SR-Madsen/KiCadLibrary/README.md

# KiCadLibrary
Library containing KiCad symbols, footprints, and 3D models for personal projects.
