SR-Madsen/KiCadLibrary/3DModels/KSZ8081RNBCA_TR.stp

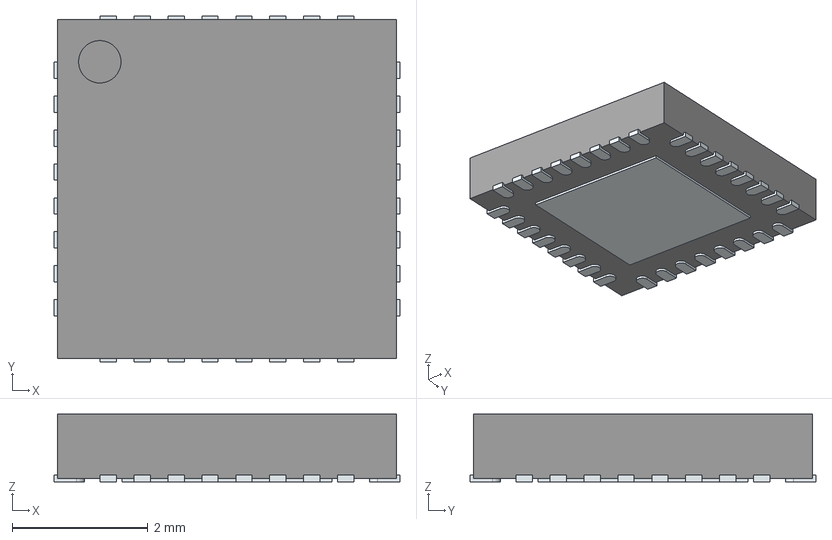
[picture p1: CAD file, 2022-05-12]
3DModels/KSZ8081RNBCA_TR.stp
5.10 x 5.10 x 1.00 mm
ThermalPin
PinsArrayLR
PinsArrayTB
