SR-Madsen/KiCadLibrary/3DModels/ECS-384-10-33B-CKY-TR.stp

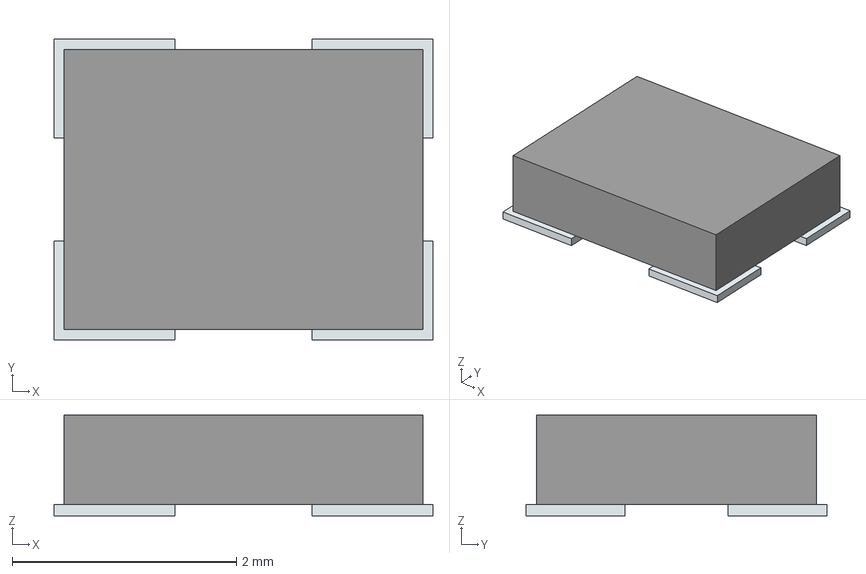
[picture p2: CAD file, 2022-05-11]
3DModels/ECS-384-10-33B-CKY-TR.stp
3.38 x 2.68 x 0.9 mm
Pins
