SR-Madsen/KiCadLibrary/3DModels/ECS-.327-12.5-12-TR.stp

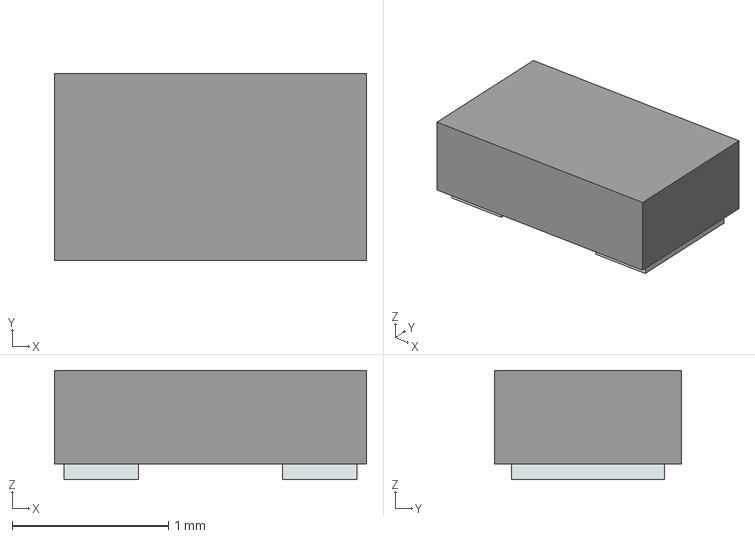
[picture p3: CAD file, 2022-05-11]
3DModels/ECS-.327-12.5-12-TR.stp
2.00 x 1.20 x 0.7 mm
Pins
