SR-Madsen/KiCadLibrary/3DModels/WF200D.stp

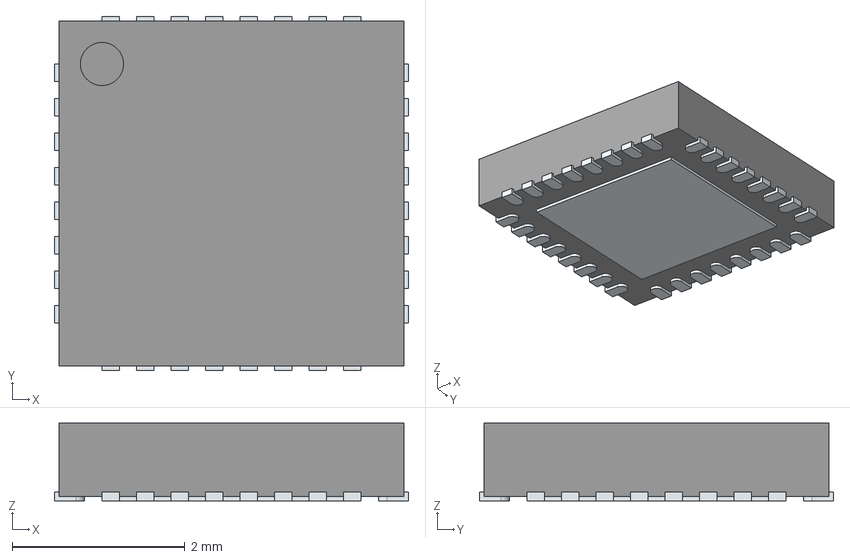
[picture p4: CAD file, 2022-05-11]
3DModels/WF200D.stp
4.10 x 4.10 x 0.9 mm
ThermalPin
PinsArrayLR
PinsArrayTB
