SR-Madsen/KiCadLibrary/3DModels/S34ML01G200BHI000.stp

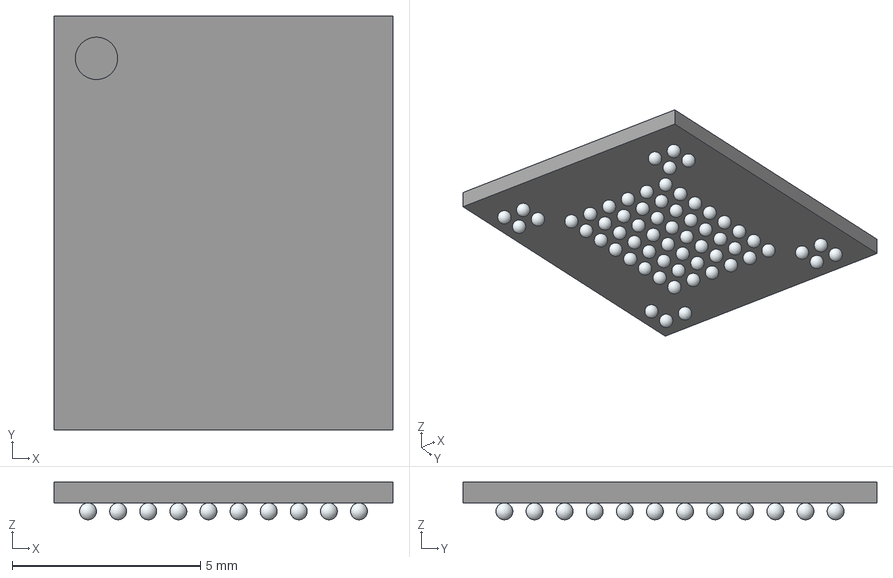
[picture p5: CAD file, 2022-05-06]
3DModels/S34ML01G200BHI000.stp
9.00 x 11.0 x 1.00 mm
A1
A2
A9
A10
B1
B9
B10
C3
C4
C5
C6
C7
C8
D3
D4
D5
D6
D7
D8
E3
E4
E5
E6
E7
E8
F3
F4
F5
F6
F7
F8
G3
G4
G5
G6
G7
G8
H3
H4
H5
H6
H7
H8
J3
J4
J5
J6
J7
J8
K3
K4
K5
K6
K7
K8
L1
L2
L9
L10
M1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
