SR-Madsen/KiCadLibrary/3DModels/PJ-102AH.step

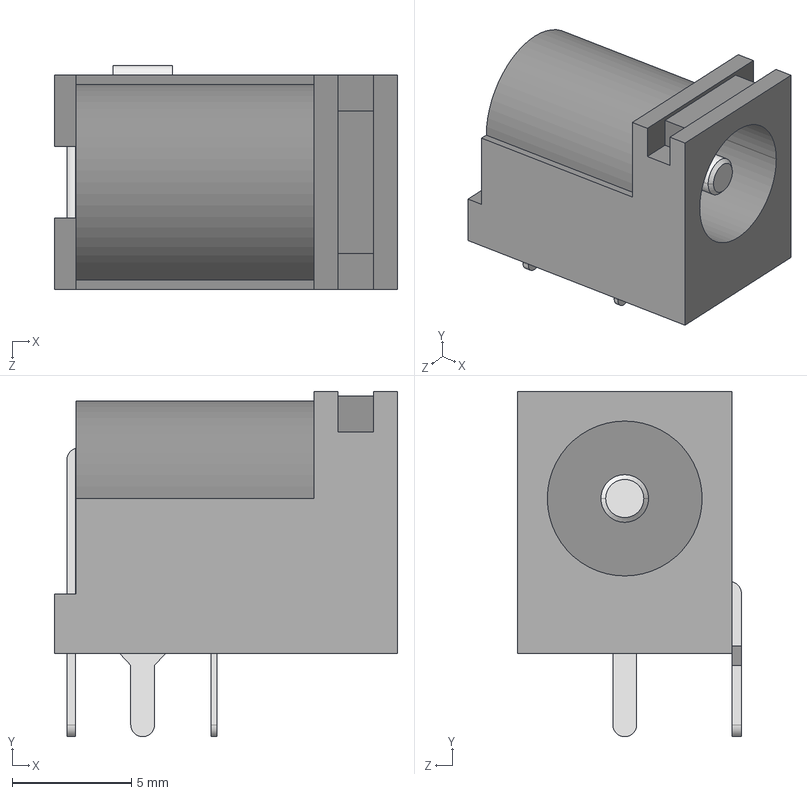
[picture p6: CAD file, 2022-05-05]
3DModels/PJ-102AH.step
14.4 x 14.5 x 9.40 mm
