SR-Madsen/KiCadLibrary/3DModels/CM1624-08DE.stp

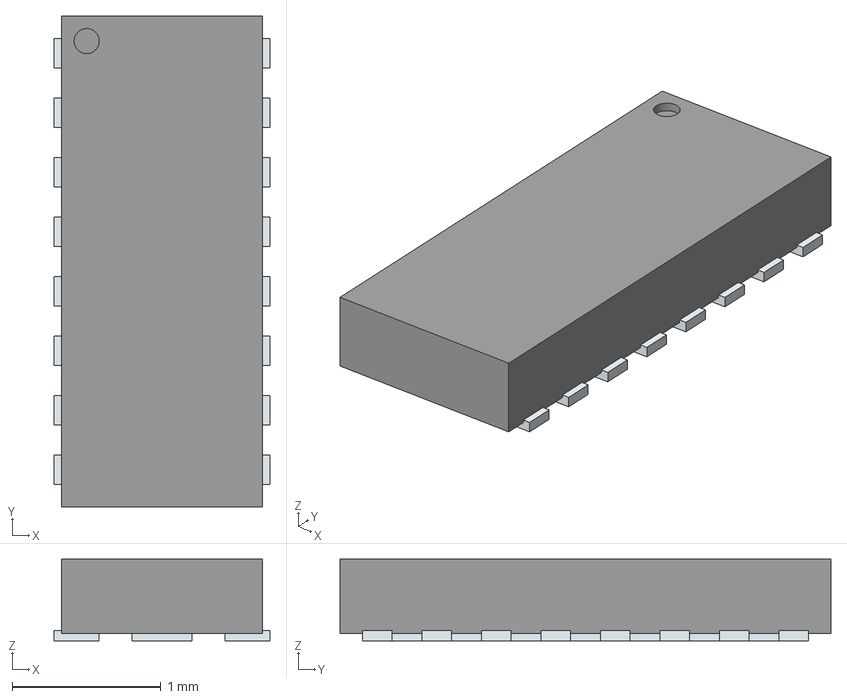
[picture p7: CAD file, 2022-04-25]
3DModels/CM1624-08DE.stp
1.45 x 3.30 x 0.55 mm
ThermalPin
PinsArrayLR
