SR-Madsen/KiCadLibrary/3DModels/TFP410PAP.stp

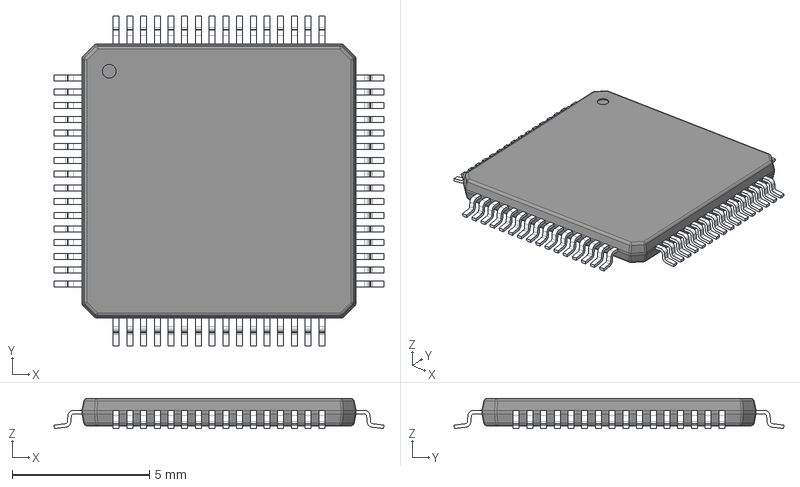
[picture p8: CAD file, 2021-12-30]
3DModels/TFP410PAP.stp
12.0 x 12.0 x 1.10 mm
BODY-QFP
LEAD-QFP x 64
THERMALPAD-PAP0064A
