SR-Madsen/KiCadLibrary/3DModels/MCP112T-315E_LB.stp

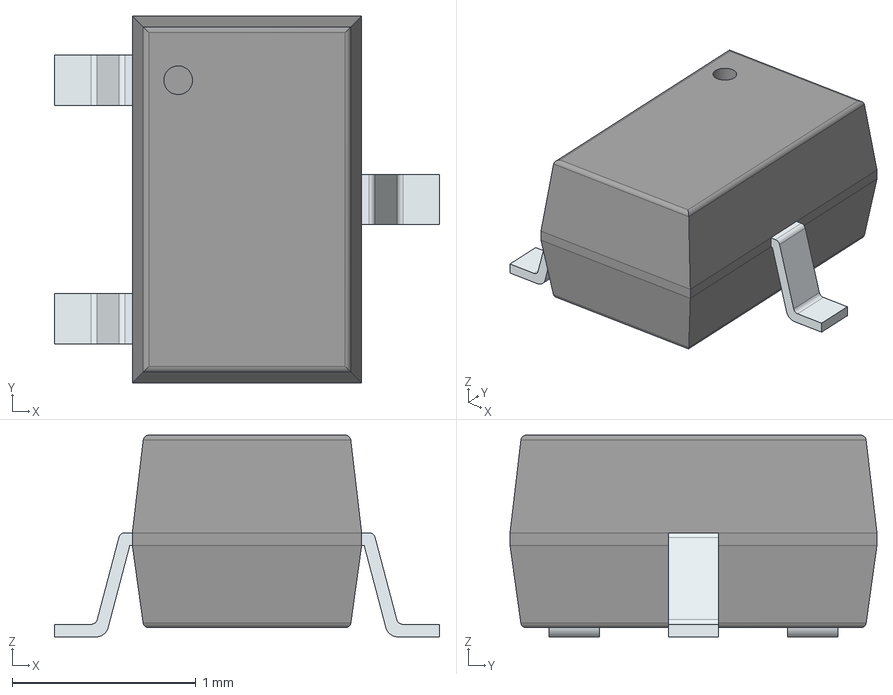
[picture p9: CAD file, 2021-02-15]
3DModels/MCP112T-315E_LB.stp
2.10 x 2.00 x 1.10 mm
PinsArrayL
FilletPinR
