SR-Madsen/KiCadLibrary/3DModels/PESD12VA-SFYL.stp

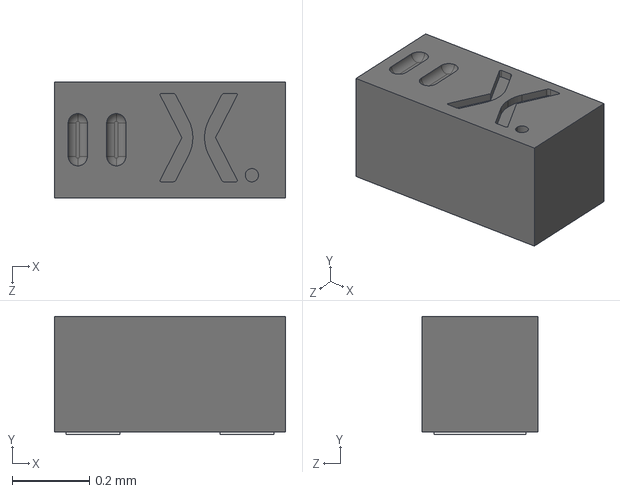
[picture p11: CAD file, 2021-02-15]
3DModels/PESD12VA-SFYL.stp
0.6 x 0.308 x 0.3 mm
