SR-Madsen/KiCadLibrary/3DModels/RJMG1BD3B8K1ANR.STEP

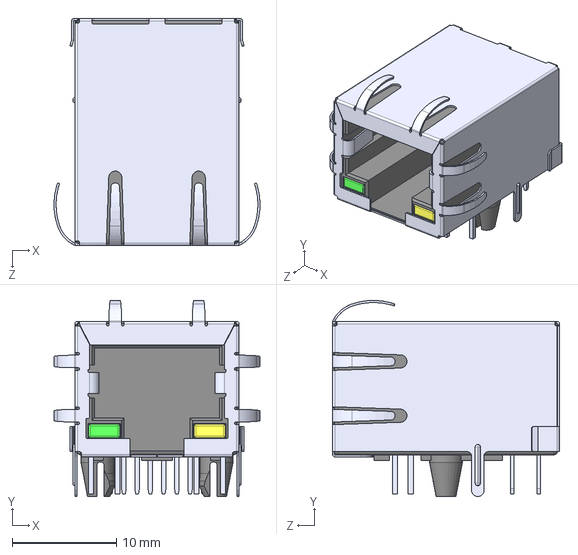
[picture p12: CAD file, 2021-01-28]
3DModels/RJMG1BD3B8K1ANR.STEP
19.7 x 18.8 x 21.8 mm
