SR-Madsen/KiCadLibrary/3DModels/MCIMX6Y2CVM08AB.stp

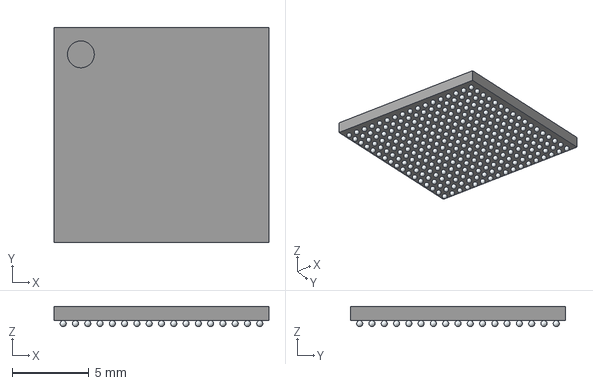
[picture p13: CAD file, 2021-01-21]
3DModels/MCIMX6Y2CVM08AB.stp
14.0 x 14.0 x 1.32 mm
