SR-Madsen/KiCadLibrary/3DModels/ECS-271.2-10-37.stp

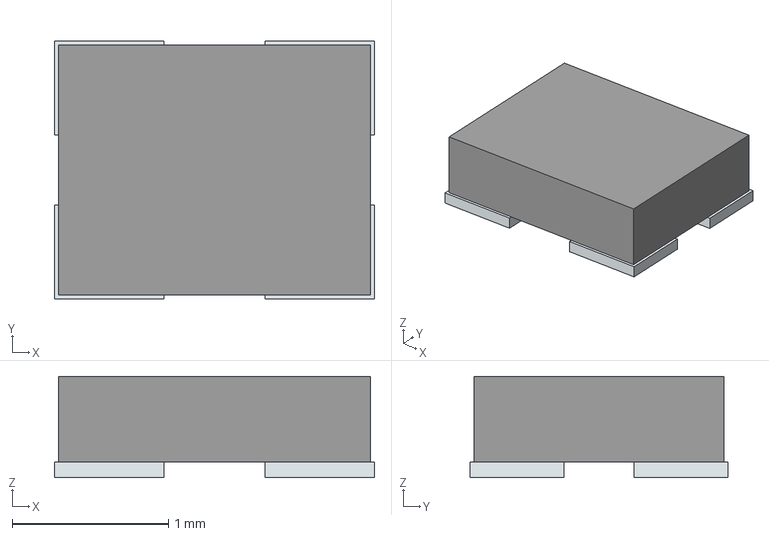
[picture p14: CAD file, 2020-12-07]
3DModels/ECS-271.2-10-37.stp
2.05 x 1.65 x 0.65 mm
Pins
