SR-Madsen/KiCadLibrary/3DModels/SHT40-AD1B-R2.stp

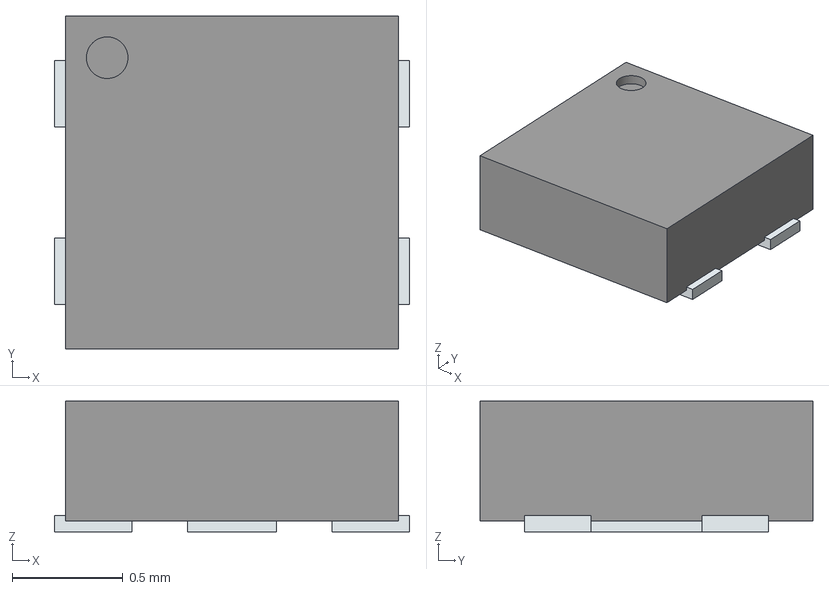
[picture p15: CAD file, 2020-12-05]
3DModels/SHT40-AD1B-R2.stp
1.60 x 1.50 x 0.59 mm
ThermalPin
PinsArrayLR
