SR-Madsen/KiCadLibrary/3DModels/IS25WQ040-JNLE.stp

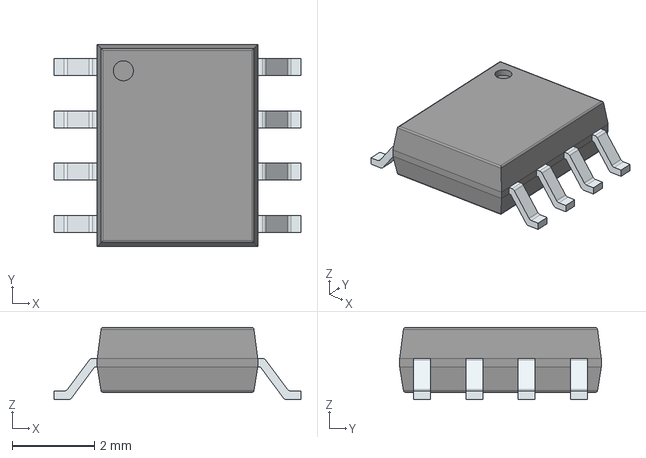
[picture p16: CAD file, 2020-11-23]
3DModels/IS25WQ040-JNLE.stp
6.00 x 4.90 x 1.75 mm
PinsArrayLR
