SR-Madsen/KiCadLibrary/3DModels/CR2450.stp

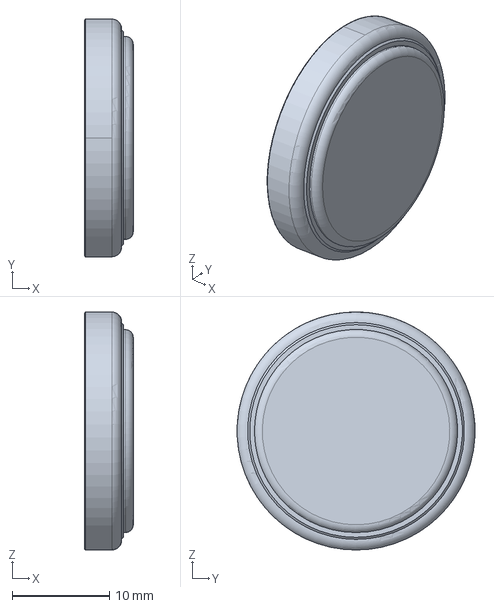
[picture p17: CAD file, 2020-11-23]
3DModels/CR2450.stp
5.00 x 24.5 x 24.5 mm
