SR-Madsen/KiCadLibrary/3DModels/2450FB15L0001.step

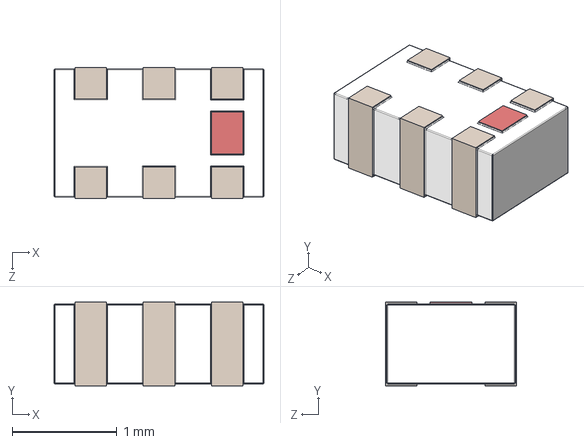
[picture p18: CAD file, 2020-11-23]
3DModels/2450FB15L0001.step
2.00 x 0.8 x 1.25 mm
