SR-Madsen/KiCadLibrary/3DModels/AT86RF232-ZX.step

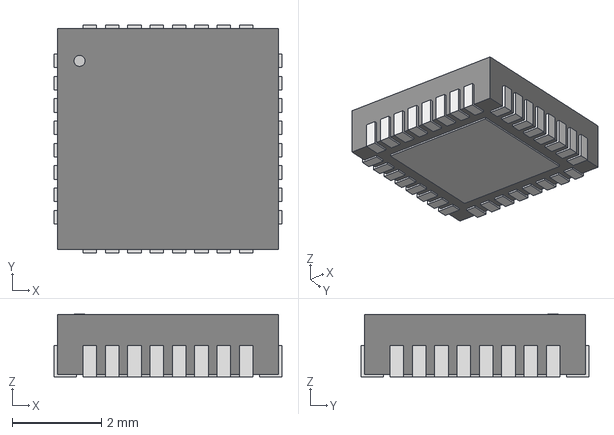
[picture p19: CAD file, 2020-11-06]
3DModels/AT86RF232-ZX.step
5.11 x 5.11 x 1.40 mm
