SR-Madsen/KiCadLibrary/3DModels/ECS-160-16-33B-CKM-TR.stp

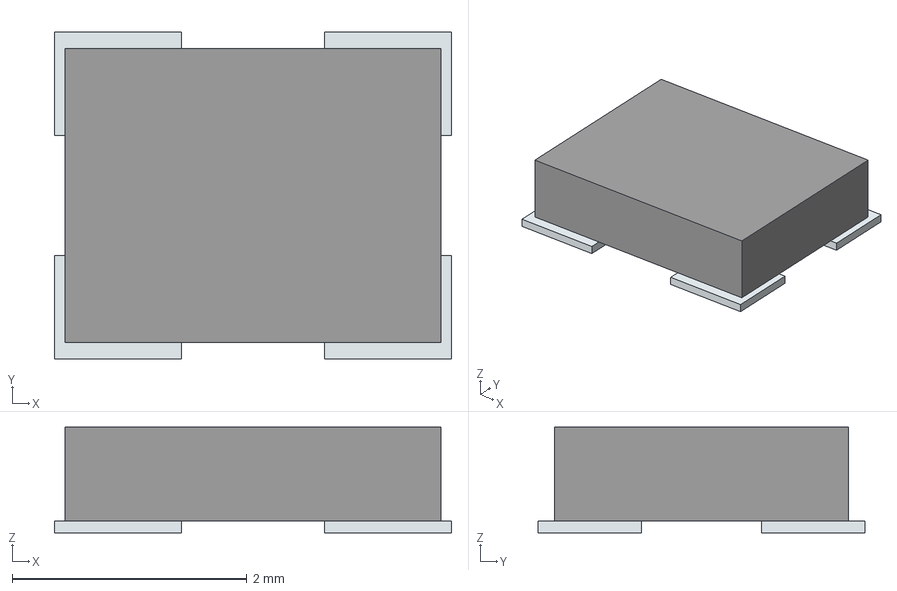
[picture p20: CAD file, 2020-11-06]
3DModels/ECS-160-16-33B-CKM-TR.stp
3.38 x 2.78 x 0.9 mm
Pins
