SR-Madsen/KiCadLibrary/3DModels/STM32L412RBT6P.stp

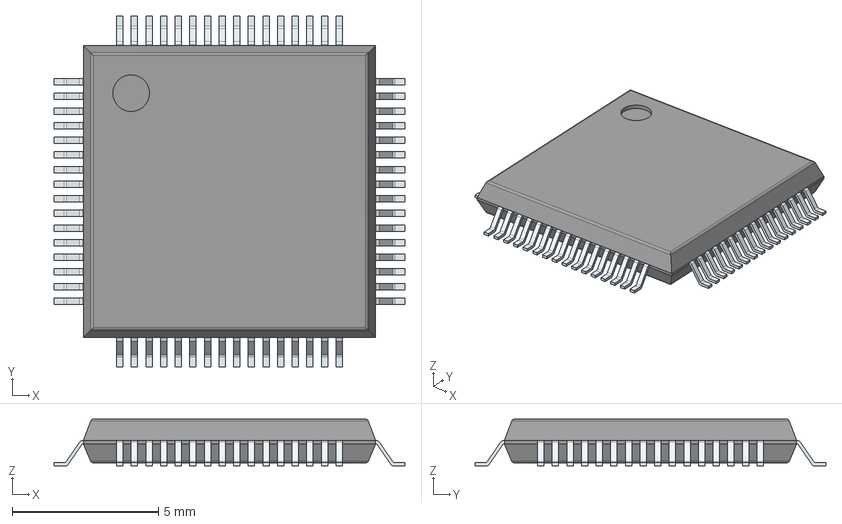
[picture p21: CAD file, 2020-11-01]
3DModels/STM32L412RBT6P.stp
12.0 x 12.0 x 1.60 mm
PinsArrayLR
PinsArrayTB
