SR-Madsen/KiCadLibrary/3DModels/YBS2207G_RAG.stp

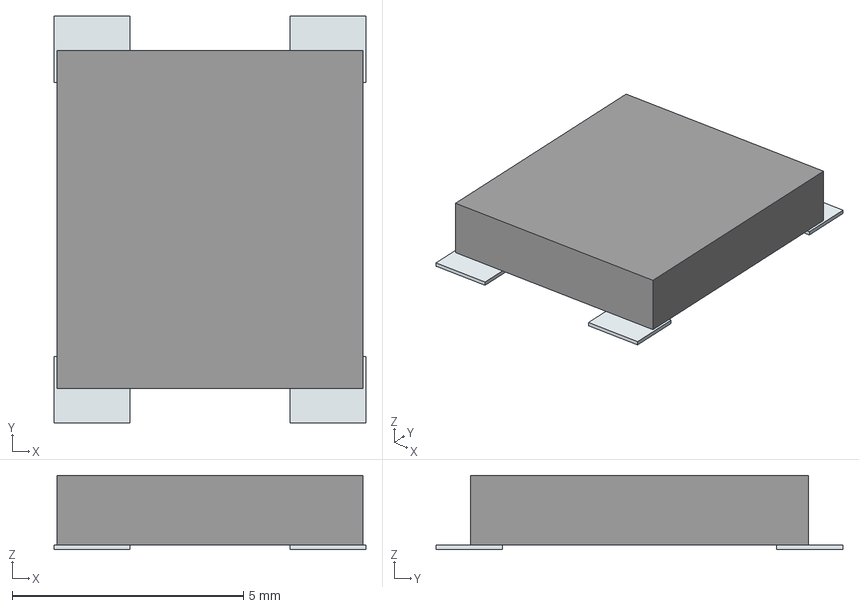
[picture p22: CAD file, 2020-10-31]
3DModels/YBS2207G_RAG.stp
6.74 x 8.79 x 1.60 mm
Pins
