SR-Madsen/KiCadLibrary/3DModels/CPC1020N.stp

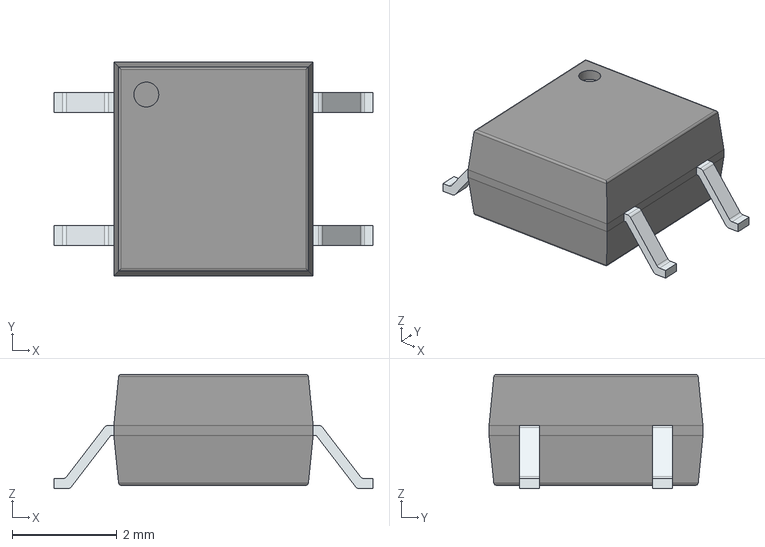
[picture p23: CAD file, 2020-10-31]
3DModels/CPC1020N.stp
6.10 x 4.09 x 2.18 mm
PinsArrayLR
