SR-Madsen/KiCadLibrary/3DModels/SRN6045TA-101M.stp

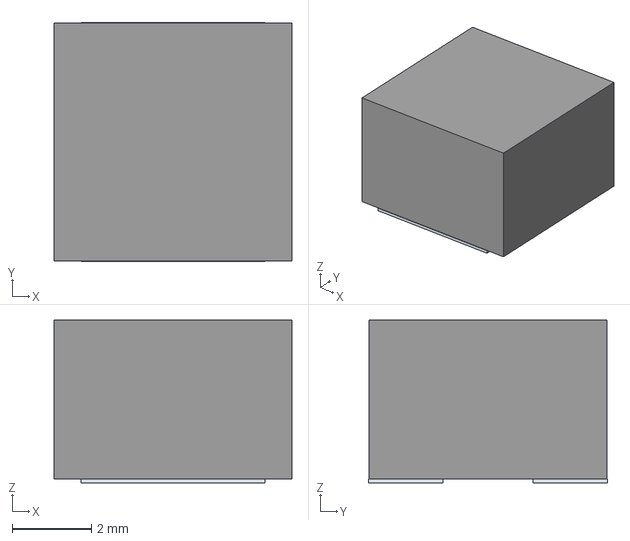
[picture p24: CAD file, 2020-10-31]
3DModels/SRN6045TA-101M.stp
6.00 x 6.03 x 4.10 mm
Pins
