SR-Madsen/KiCadLibrary/3DModels/SRR1208-821KL.stp

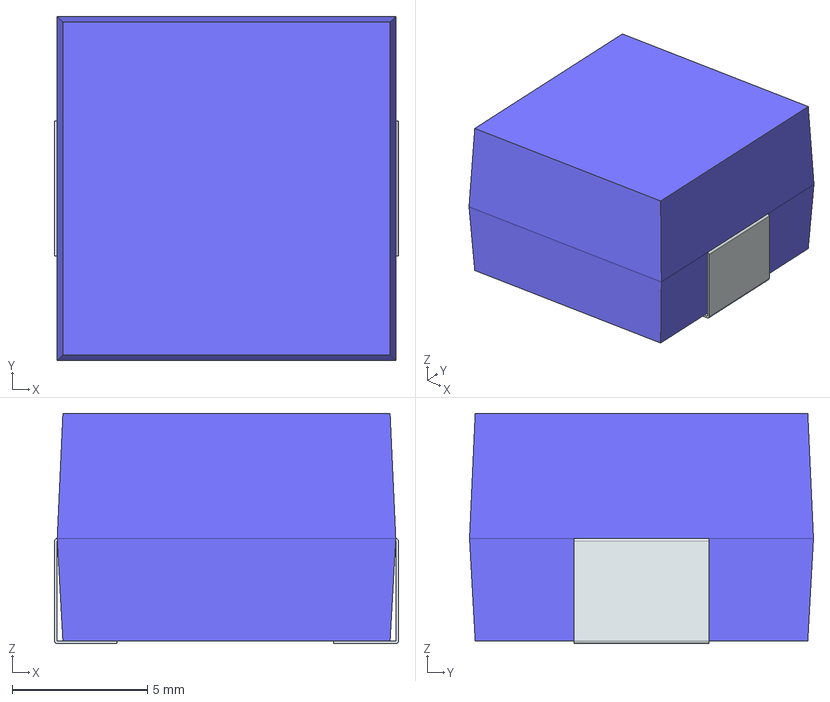
[picture p25: CAD file, 2020-10-31]
3DModels/SRR1208-821KL.stp
12.7 x 12.7 x 8.50 mm
FilletPin1
FilletPin2
