SR-Madsen/KiCadLibrary/3DModels/ST1S41PHR.stp

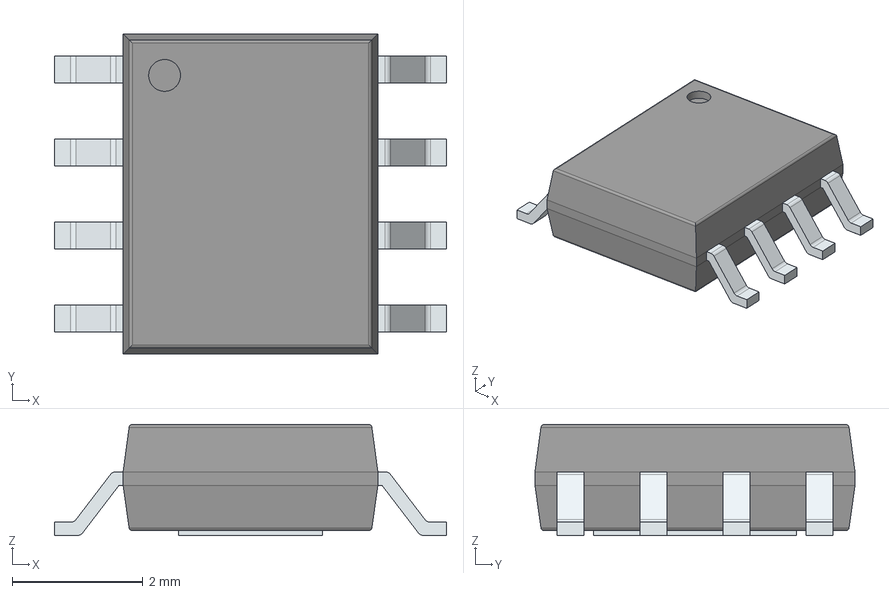
[picture p26: CAD file, 2020-10-31]
3DModels/ST1S41PHR.stp
6.00 x 4.90 x 1.70 mm
PinsArrayLR
ThermalPad
