SR-Madsen/KiCadLibrary/3DModels/VIPER318HDTR.stp

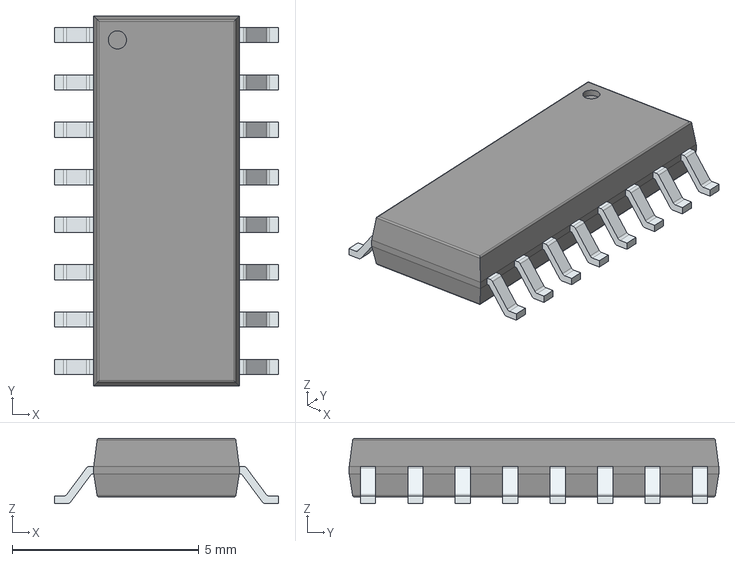
[picture p27: CAD file, 2020-10-31]
3DModels/VIPER318HDTR.stp
6.00 x 9.90 x 1.75 mm
PinsArrayLR
