SR-Madsen/KiCadLibrary/3DModels/BK1608HS601-T.stp

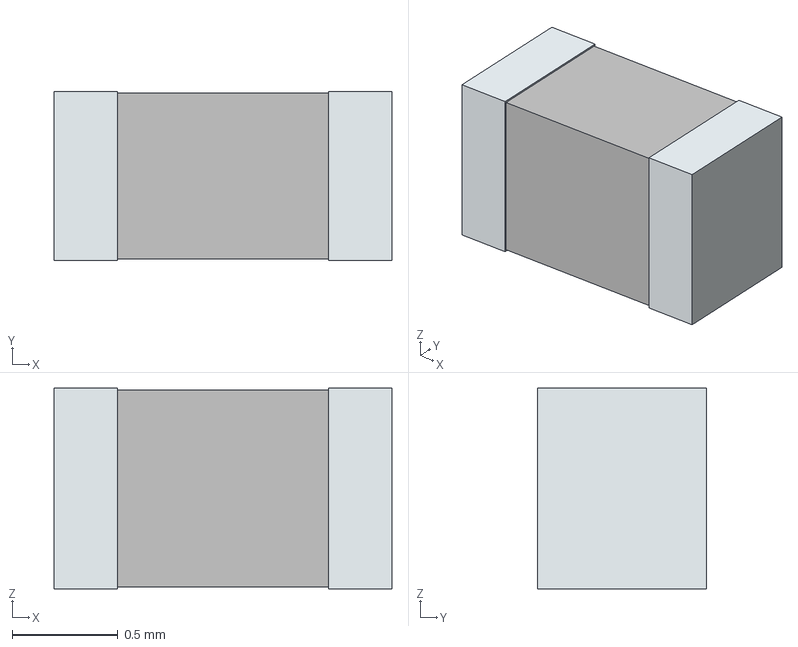
[picture p28: CAD file, 2020-10-31]
3DModels/BK1608HS601-T.stp
1.60 x 0.8 x 0.95 mm
term1
term2
