SR-Madsen/KiCadLibrary/3DModels/ECS-5032MV-250-CN-TR.stp

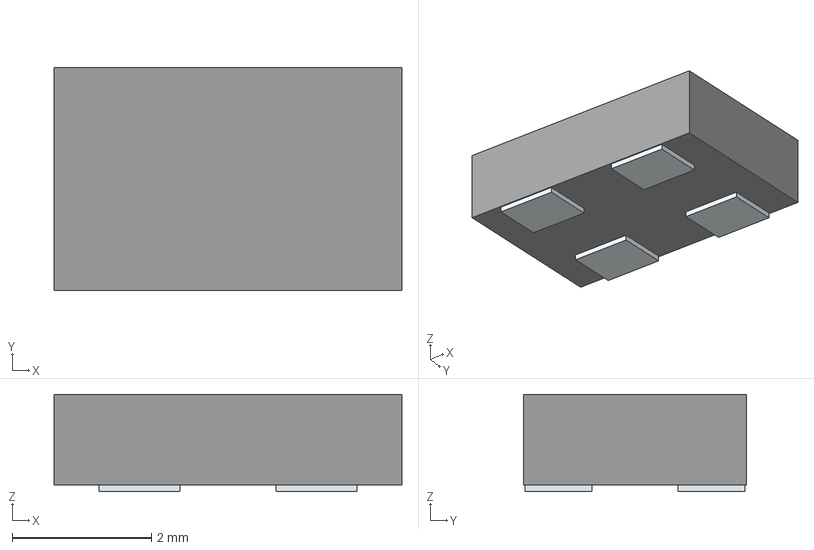
[picture p29: CAD file, 2020-10-31]
3DModels/ECS-5032MV-250-CN-TR.stp
5.00 x 3.20 x 1.40 mm
Pins
