SR-Madsen/KiCadLibrary/(list of files, cad)

Other CAD files:
3DModels/CLRC66303HNY.stp
3DModels/10118194-0001LF.STEP
3DModels/208658-1051.stp
3DModels/5025700893.stp
3DModels/61202021621.stp
3DModels/64600001003.stp
3DModels/AP62301WU-7.stp
3DModels/B66418W1008D1.stp
3DModels/M50-3600542R.stp
