SR-Madsen/KiCadLibrary/(commit log)

2020-10-31 Added all files used for Cocktail Machine project.
    [61202021621.stp, 64600001003.stp, B66418W1008D1.stp, BK1608HS601-T.stp, CPC1020N.stp, ECS-5032MV-250-CN-TR.stp, M50-3600542R.stp, SRN6045TA-101M.stp]
2020-11-01 Added STM32L4 processor for IoT project. Added high-efficiency DC-DC-converters for low-power applications.
    [STM32L412RBT6P.stp]
2020-11-06 Added ZigBee transceiver, 16 MHz crystal, temperature/humidity IC.
    [AT86RF232-ZX.step, ECS-160-16-33B-CKM-TR.stp, SHTC3.stp]
2020-11-23 Added modules for IoT Slave board.
    [10118194-0001LF.STEP, 2450FB15L0001.step, CR2450.stp, IS25WQ040-JNLE.stp]
2020-11-28 Renamed 2450 battery cell holder for clarity.
2020-12-05 Added NFC Frontend and SHT40.
    [CLRC66303HNY.stp, SHT40-AD1B-R2.stp]
2020-12-05 Added 3.3 V high-efficiency converter.
2020-12-07 Added ECS 27.12 MHz crystal.
    [ECS-271.2-10-37.stp]
2020-12-11 Added RJ45 with integrated magnetics and LEDs, added 470 nH inductor, added 13.56 MHz NFC antenna.
    [RJMG1BD3B8K1ANR.stp]
2020-12-18 Fixed inductor footprint size.
2021-01-21 Added i.MX 6ULL 800 MHz microprocessor for Smart Mirror project.
    [MCIMX6Y2CVM08AB.stp]
2021-01-28 Added RJ45 connector with LEDs and magnetics.
    [RJMG1BD3B8K1ANR.STEP, RJMG1BD3B8K1ANR.stp]
2021-02-15 Added voltage converters, supervisor, DRAM, and ESD diode for Smart Mirror.
    [AP62301WU-7.stp, MCP112T-315E_LB.stp, MT41K128M16JT-125_K.stp, PESD12VA-SFYL.stp]
2021-12-30 Added TFP410PAP (#1)
    [TFP410PAP.stp]
2022-04-25 Added SD filter and USB 3.3V
    [CM1624-08DE.stp]
2022-04-25 Added SD connector footprint.
2022-05-05 Added additional components, minor fixes, added 3D models.
    [208658-1051.stp, 5025700893.stp, PJ-102AH.step]
2022-05-06 Added NAND flash.
    [S34ML01G200BHI000.stp]
2022-05-11 Added various oscillators, as well as a Wi-Fi module.
    [ECS-.327-12.5-12-TR.stp, ECS-384-10-33B-CKY-TR.stp, WF200D.stp]
2022-05-12 Added KSZ8081RNB Ethernet PHY. Minor changes to some others.
    [KSZ8081RNBCA_TR.stp]
2022-08-03 Added libraries for KiCad 6.
